cpldcpu/Splinter/Design/booster.xlsx

Sheet: calc
L1 [µH] | fpwm | DC | R1 | Iin [mA] | Iout [mA] | Vout [V] | Iswitchav [mA] | Pin [W] | Pout [W] | eta [%] | Switcher target
10 | 1000000 | 0.5 | 50 | 38.3 | 7.6 | 9.2 |  | 0.1915 | 0.06992 | 36.51174935%
10 | 1000000 | 0.75 | 50 | 59.05 | 7.9 | 9.5 | 50 | 0.29525 | 0.07505 | 25.41913633% | 15V
10 | 1000000 | 0.25 | 50 | 17.9 | 6.6 | 8 | 11.2 | 0.0895 | 0.0528 | 58.99441341% | 1m
10 | 2000000 | 0.25 | 50 | 15.9 | 6.6 | 7.93 | 9.3 | 0.0795 | 0.052338 | 65.83396226%
10 | 2000000 | 0.5 | 50 | 28 | 7.9 | 9.55 | 20 | 0.14 | 0.075445 | 53.88928571% | 0.03
10 | 2000000 | 0.5 | 20 | 35.9 | 9.9 | 11.9 | 25 | 0.1795 | 0.11781 | 65.63231198%
10 | 2000000 | 0.5 | 5 | 41.7 | 11.4 | 13.7 | 30 | 0.2085 | 0.15618 | 74.90647482% | 7500
10 | 2000000 | 0.5 | 1 | 44.9 | 13.1 | 15.6 | 31.8 | 0.2245 | 0.20436 | 91.02895323%
10 | 500000 | 0.5 | 1 | 128 | 19.6 | 23.5 | 109 | 0.64 | 0.4606 | 71.96875%
10 | 500000 | 0.25 | 1 | 43.2 | 12 | 14.4 | 30 | 0.216 | 0.1728 | 80% | 1250
10 | 1000000 | 0.25 | 1 | 27.1 | 9.6 | 11.6 | 17 | 0.1355 | 0.11136 | 82.18450185%
10 | 1000000 | 0.5 | 1 | 76 | 15.7 | 18.9 | 60 | 0.38 | 0.29673 | 78.08684211%
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
