cpldcpu/Splinter/Testboards/README.md

# Testboards

Hardware test boards for Splinter.

License: CC-BY-SA-4.0 (see `Testboards/LICENSE`).

## Layout

- `R0/` - first bring-up revision.

## R0

R0 contains the original EasyEDA Pro project files and a schematic export.

Files (EasyEDA Pro projects):
- `R0/ProDoc_Schematic_2025-12-04.epro` - schematic project (source).
- `R0/ProDoc_PCB2_2025-12-04.epro` - PCB/layout project (source).

Exports:
- `R0/SCH_Splinter R0_2025-12-04.pdf` - schematic PDF export (easy to view without EasyEDA).

Status: bring-up / work in progress (expect bugs).
