cpldcpu/Splinter/Testboards/R0/SCH_Splinter R0_2025-12-04.pdf

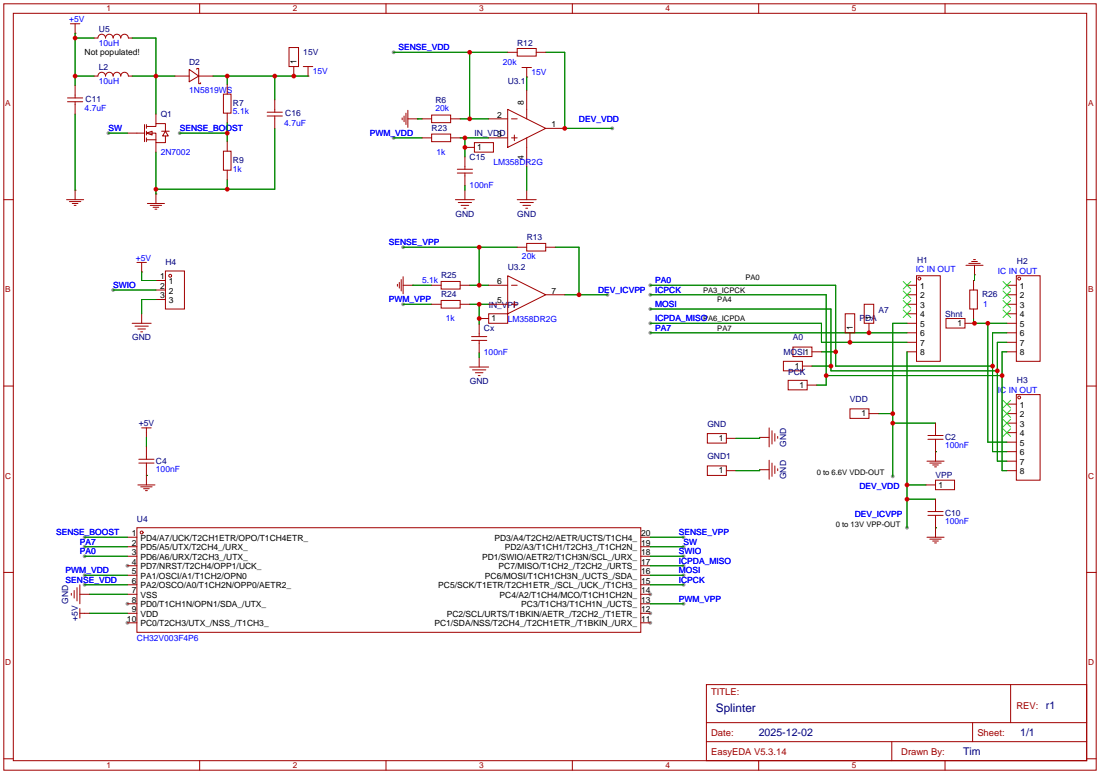
[picture p10: page 1]
