cpldcpu/Splinter/Design/SimpleBoost_V4_simple.asc

C1: polcap; 100n; V=25 Irms=400m Rser=0.2 Lser=0
C2: cap; 100p
D1: schottky; 1N5819
L1: ind; 4.7µ; Ipk=0.75 Rser=0.48 Rpar=0 Cpar=0
M1: nmos; 2N7002
R1: res; 1
R2: res; 1
R3: res; 1k
RLOAD: res; 1.2k
V1: voltage; PULSE(0 5 0 10n 10n 0.25u 1u 100000)
V2: voltage; 5
Named nets: 0, VPP
.tran 0 2.2m 0
.meas TRAN InputCurrent AVG I(V2) FROM 1ms TO 2ms
.meas TRAN OutputCurrent AVG I(Rload) FROM 1ms TO 2ms
.meas TRAN OutputVoltage AVG V(Vpp) FROM 1ms TO 2ms
.meas TRAN SWCurrent AVG I(R1) FROM 1ms TO 2ms
