cpldcpu/Splinter/Design/SimpleBoost_V5_opamp.asc

C1: polcap; 100n; V=25 Irms=400m Rser=0.2 Lser=0
C2: cap; 100p
C3: cap; 100n
D1: schottky; 1N5819
L1: ind; 4.7µ; Ipk=0.75 Rser=0.48 Rpar=0 Cpar=0
M1: nmos; 2N7002
R1: res; 1
R2: res; 1
R3: res; 1k
R4: res; 1k
R5: res; 20k
R6: res; 6.8k
RLOAD: res; 1.2k
U1: LT1013
V1: voltage; PULSE(0 5 0 10n 10n 0.35u 1u 100000)
V2: voltage; 5
V3: voltage; PULSE(0 5 1m 1m 1m 1u 2n 2)
Named nets: 0, V15, Vctrl, VPP
.tran 0 2.2m 0
.meas TRAN InputCurrent AVG I(V2) FROM 1ms TO 2ms
.meas TRAN OutputCurrent AVG I(Rload) FROM 1ms TO 2ms
.meas TRAN OutputVoltage AVG V(Vpp) FROM 1ms TO 2ms
.meas TRAN SWCurrent AVG I(R1) FROM 1ms TO 2ms
