cpldcpu/Splinter/(list of files, drawings)

Other design files:
Testboards/R0/ProDoc_PCB2_2025-12-04.epro
Testboards/R0/ProDoc_Schematic_2025-12-04.epro
